Tronix286/i8080_clock/pics/photo_2023-03-10_09-42-11.jpg

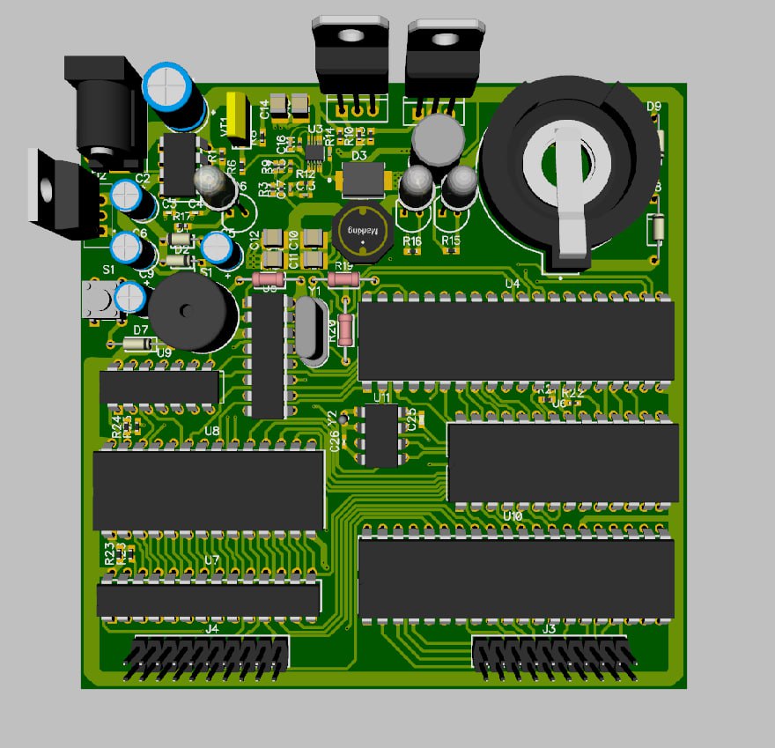
pics/photo_2023-03-10_09-42-11.jpg
