Tronix286/i8080_clock/pics/photo_2023-10-03_08-44-36.jpg

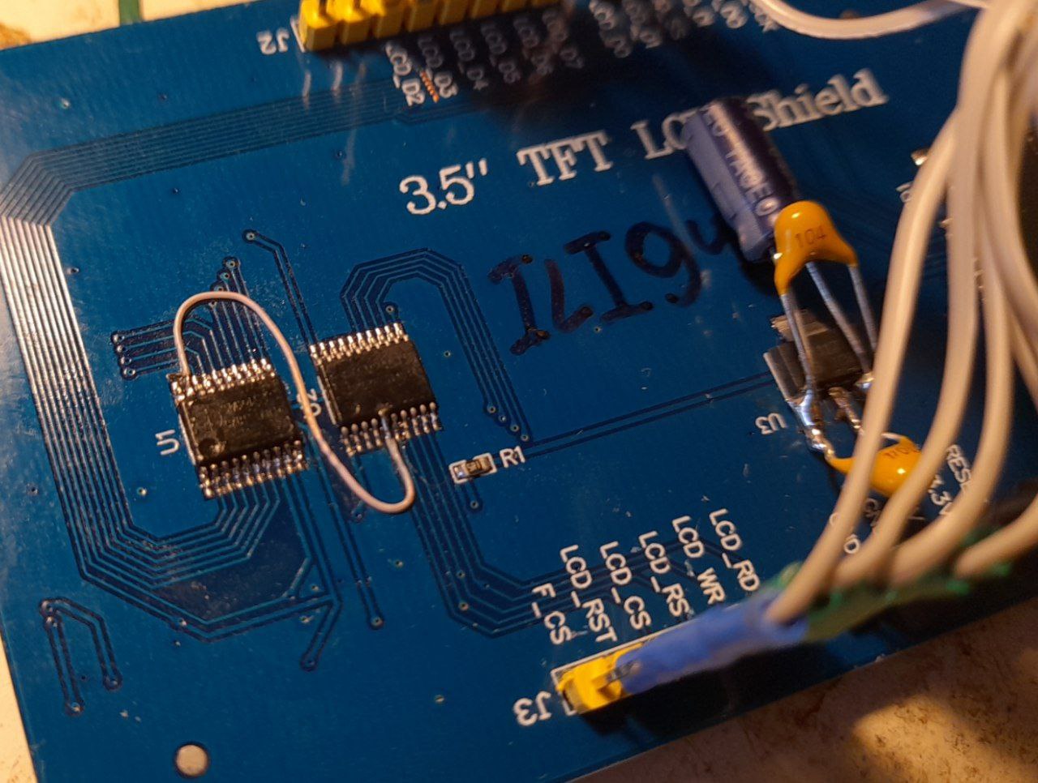
pics/photo_2023-10-03_08-44-36.jpg
