Tronix286/i8080_clock/hardware/DipTrace Schematic - clock_v1_1.pdf

## GND

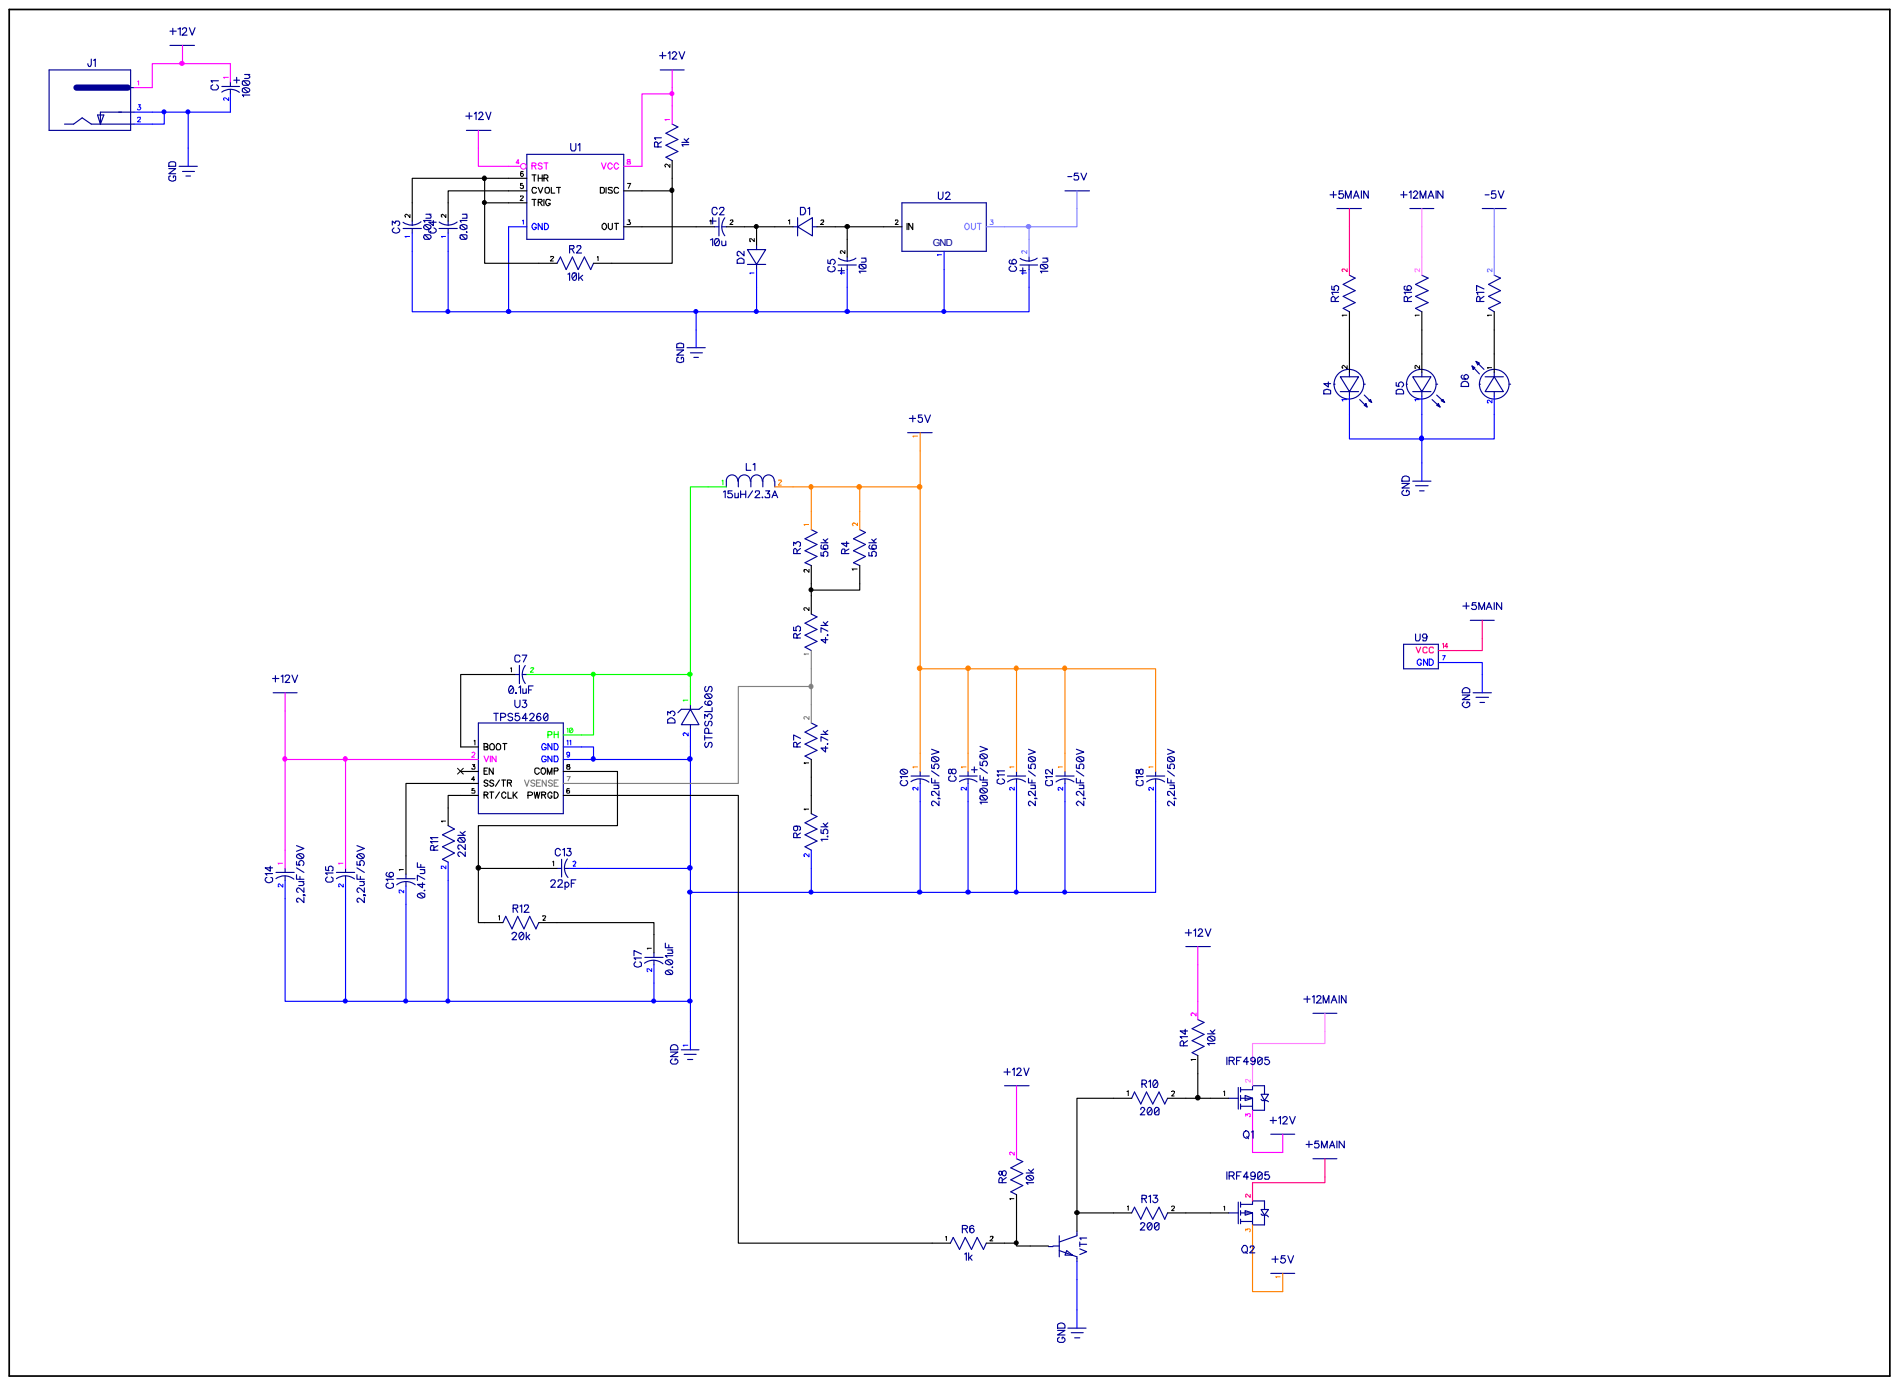
[picture p8: page 1]

## D_BUS

## ADDR

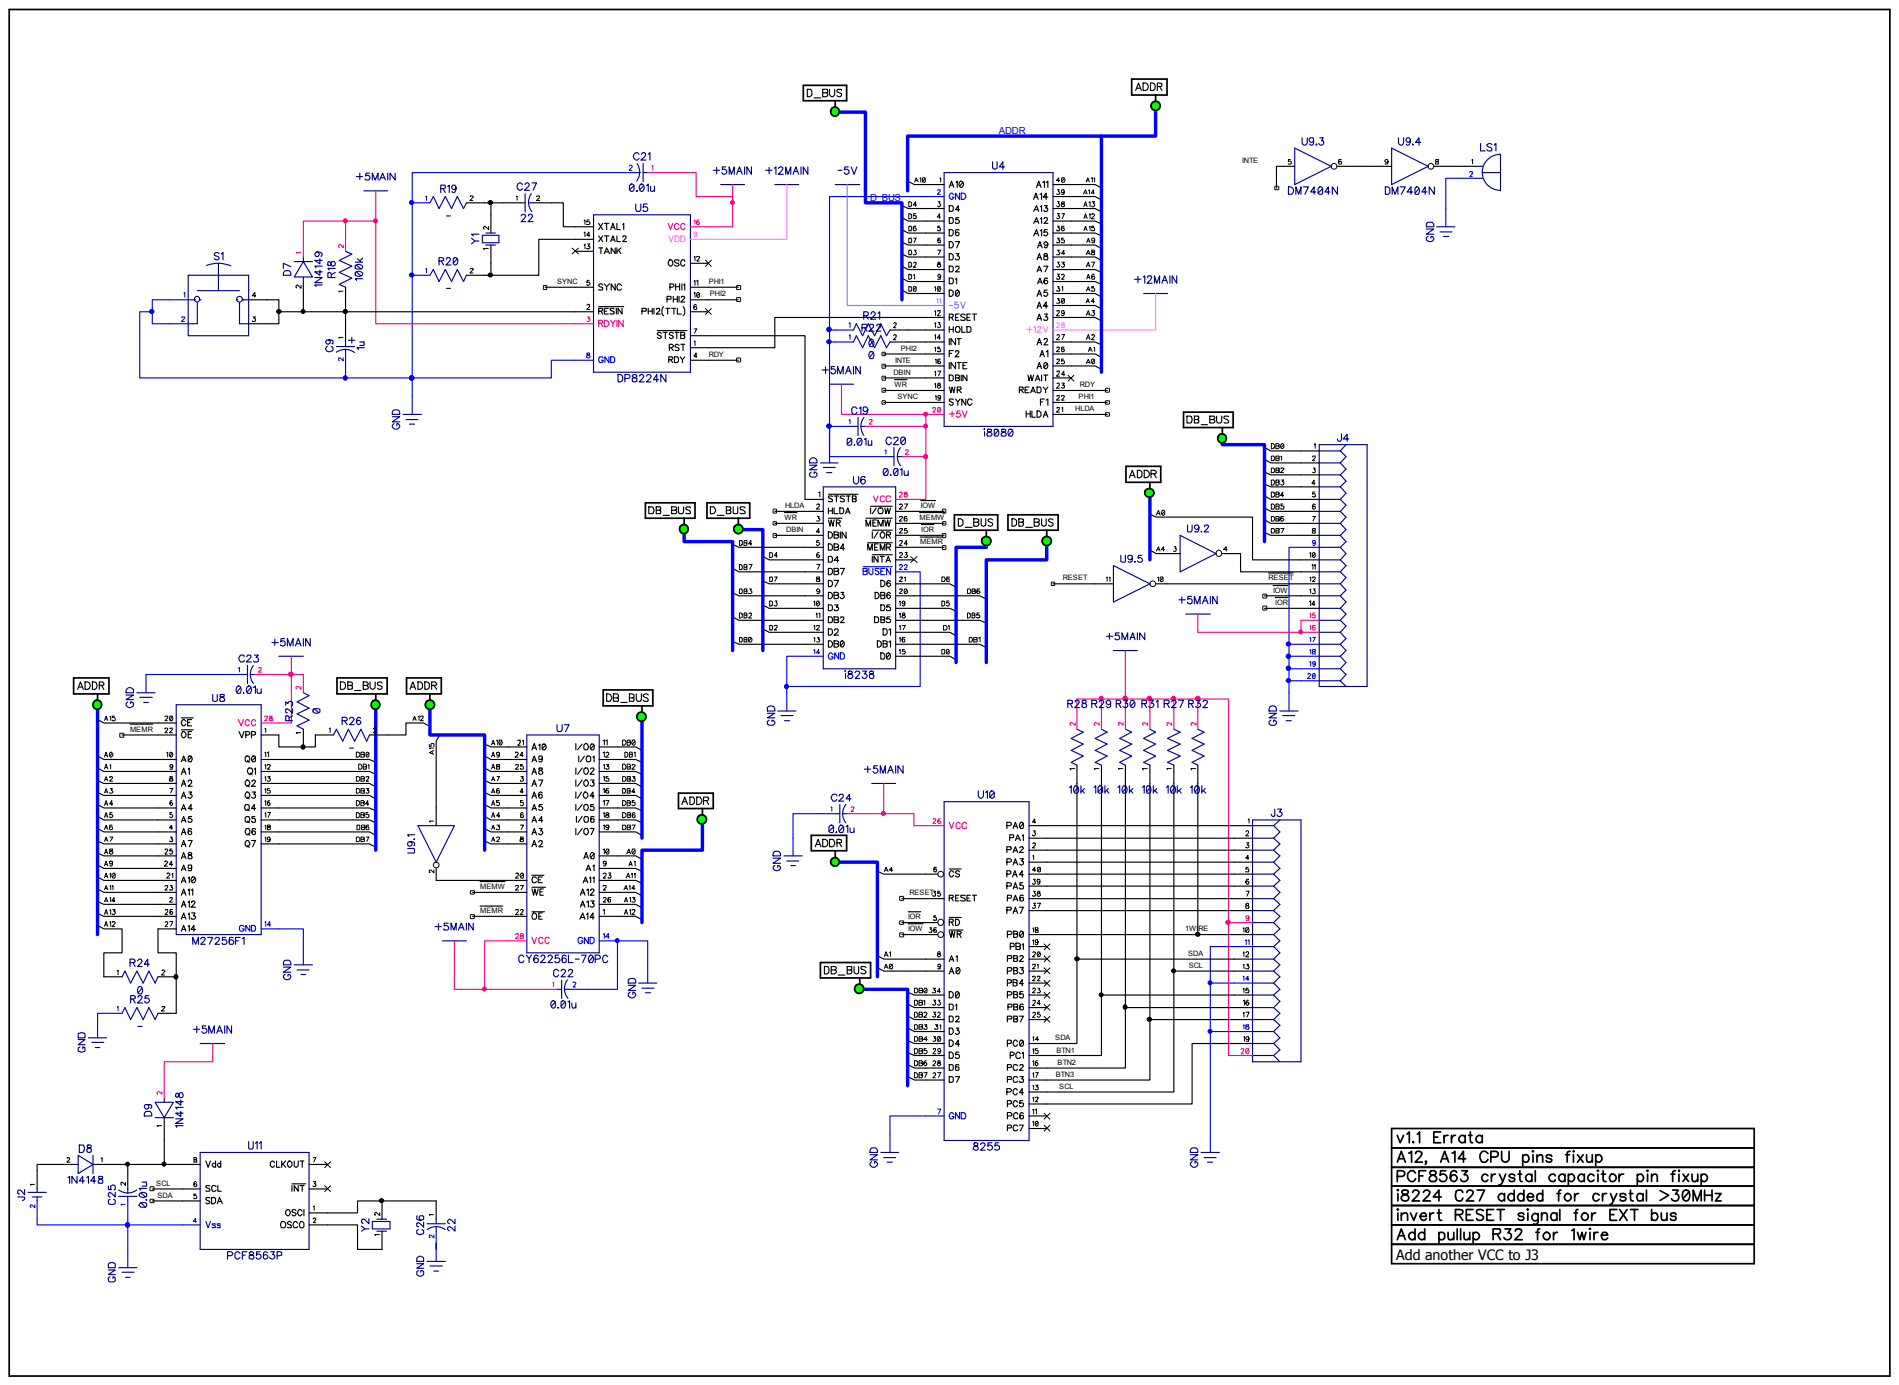
[picture p9: page 2]
SYNC; PHI1; PHI2; RDY; HLDA; DBIN; MEMW; IOW; IOR; MEMR; RESET; SCL; SDA; BTN1; BTN2; BTN3; 1WIRE; INTE

Add another VCC to J3
