Tronix286/i8080_clock/(list of files, drawings)

Other design files:
hardware/clock_v0_0.dip
hardware/clock_v1_0.dch
hardware/clock_v1_1.dch
hardware/clock_v1_1.dip
