Tronix286/i8080_clock/software/firmware/pic.h

//////////////////////////////////////////////////////////////////////////////////	 
//本程序只供学习使用，未经作者许可，不得用于其它任何用途
//测试硬件：单片机STC12C5A60S2,晶振30M  单片机工作电压3.3V
//QDtech-LCD液晶驱动 for C51
//xiao冯@ShenZhen QDtech co.,LTD
//公司网站:www.qdtft.com
//淘宝网站：http://qdtech.taobao.com
//wiki技术网站：http://www.lcdwiki.com
//我司提供技术支持，任何技术问题欢迎随时交流学习
//固话(传真) :+86 0755-23594567 
//手机:15989313508（冯工） 
//邮箱:lcdwiki01@gmail.com    support@lcdwiki.com    goodtft@163.com
//技术支持QQ:3002773612  3002778157
//技术交流QQ群:324828016
//创建日期:2018/7/7
//版本：V1.0
//版权所有，盗版必究。
//Copyright(C) 深圳市全动电子技术有限公司 2018-2028
//All rights reserved
//********************************************************************************
//=========================================电源接线================================================//
//5V接DC 5V电源
//GND接地
//=======================================液晶屏数据线接线==========================================//
//本模块默认数据总线类型为16位并口
//液晶屏模块             C51单片机
// DB0~DB7       接       P00~P07        //数据低8位
// DB8~DB15      接       P20~P27        //数据高8位
//=======================================液晶屏控制线接线==========================================//
//液晶屏模块             C51单片机
// LCD_CS        接        P13           //片选控制信号
// LCD_RST       接        P33           //复位信号
// LCD_RS        接        P12           //数据/命令选择控制信号
// LCD_WR        接        P11           //写控制信号
// LCD_RD        接        P10           //读控制信号
//=========================================触摸屏接线=========================================//
//STC89C52RC单片机ROM太小，无法运行带触摸功能的程序，所以触摸屏不需要接线
//不使用触摸或者模块本身不带触摸，则可不连接
//触摸屏使用的数据总线类型为SPI
//触摸屏模块             C51单片机
//  T_CLK        接        P36          //触摸屏SPI时钟信号
//  T_CS         接        P37          //触摸屏片选控制信号
//  T_DIN        接        P34          //触摸屏SPI写信号
//  T_DO         接        P35          //触摸屏SPI读信号
//  T_IRQ        接        P40          //触摸屏响应检查信号，如单片机无P4组，请自行更改其他可用IO并修改代码定义
//**************************************************************************************************/	
#ifndef __PIC_H
#define __PIC_H 

unsigned char gImage_temperature[512] = { /* 0X10,0X04,0X00,0X20,0X00,0X20, */
0X00,0X00,0X00,0X00,0X06,0XDF,0XB2,0X00,0X00,0X00,0X00,0X00,0X00,0X00,0X00,0X00,
0X00,0X00,0X00,0X00,0X6F,0XA7,0XDE,0X10,0X00,0X00,0X00,0X00,0X00,0X00,0X00,0X00,
0X00,0X00,0X00,0X00,0XDA,0X00,0X0F,0X70,0X00,0X00,0X00,0X00,0X00,0X00,0X00,0X00,
0X00,0X00,0X00,0X00,0XF5,0X00,0X0A,0XA0,0X00,0X00,0X00,0X00,0X00,0X00,0X00,0X00,
0X00,0X00,0X00,0X00,0XF5,0X00,0X0A,0XA0,0X00,0X00,0X00,0X00,0X00,0X00,0X00,0X00,
0X03,0XAA,0XAA,0X30,0XF5,0X00,0X0A,0XA0,0X00,0X00,0X00,0X00,0X00,0X00,0X00,0X00,
0X03,0XAA,0XAA,0X30,0XF5,0X00,0X0A,0XA0,0X00,0X00,0X00,0X00,0X00,0X00,0X00,0X00,
0X00,0X00,0X00,0X00,0XF5,0X00,0X0A,0XA0,0X00,0X00,0X00,0X00,0X00,0X00,0X00,0X00,
0X00,0X00,0XBF,0X60,0XF5,0X00,0X0A,0XA0,0X00,0X00,0X00,0X00,0X00,0X00,0X00,0X00,
0X00,0X00,0X25,0X00,0XF5,0X00,0X0A,0XA0,0X00,0X06,0X9A,0X83,0X00,0X02,0X85,0X00,
0X00,0X00,0X25,0X00,0XF5,0X00,0X0A,0XA0,0X00,0XCF,0XBA,0XDF,0X60,0X0F,0XEF,0X50,
0X00,0X00,0XBF,0X60,0XF5,0X00,0X0A,0XA0,0X06,0XF3,0X00,0X08,0XF1,0X3F,0X5E,0X80,
0X00,0X00,0X00,0X00,0XF5,0X00,0X0A,0XA0,0X09,0XB0,0X00,0X01,0XF3,0X0C,0XFF,0X20,
0X03,0XAA,0XAA,0X30,0XF5,0X06,0X0A,0XA0,0X0A,0XA0,0X00,0X00,0X10,0X00,0X30,0X00,
0X03,0XAA,0XAA,0X30,0XF5,0X5F,0X0A,0XA0,0X0A,0XA0,0X00,0X00,0X00,0X00,0X00,0X00,
0X00,0X00,0X00,0X00,0XF5,0X5F,0X0A,0XA0,0X0A,0XA0,0X00,0X00,0X00,0X00,0X00,0X00,
0X00,0X00,0XBF,0X60,0XF5,0X5F,0X0A,0XA0,0X0A,0XA0,0X00,0X00,0X00,0X00,0X00,0X00,
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
0X00,0X00,0X00,0X00,0X00,0X00,0X00,0X00,0X00,0X00,0X00,0X00,0X00,0X00,0X00,0X00,
0X00,0X00,0X00,0X00,0X00,0X00,0X00,0X00,0X00,0X00,0X00,0X00,0X00,0X00,0X00,0X00,
0X00,0X00,0X00,0X00,0X00,0X00,0X00,0X00,0X00,0X00,0X00,0X00,0X00,0X00,0X00,0X00,
};

#endif
