Tronix286/i8080_clock/software/firmware/types.h

#ifndef _TYPES_H
#define _TYPES_H
#include <stdint.h>
 typedef int8_t s8;
 typedef uint8_t u8;
 typedef int16_t s16;
 typedef uint16_t u16;
 typedef int32_t s32;
 typedef uint32_t u32;
 typedef int64_t s64;
 typedef uint64_t u64;
 
 typedef int8_t int8;
 typedef uint8_t uint8;
 typedef int16_t int16;
 typedef uint16_t uint16;
 typedef int32_t int32;
 typedef uint32_t uint32;
 typedef int64_t int64;
 typedef uint64_t uint64;
#endif /* _TYPES_H */
