Tronix286/i8080_clock/software/firmware/gui.c

//////////////////////////////////////////////////////////////////////////////////	 
//本程序只供学习使用，未经作者许可，不得用于其它任何用途
//测试硬件：单片机STC12C5A60S2,晶振30M  单片机工作电压3.3V
//QDtech-LCD液晶驱动 for C51
//xiao冯@ShenZhen QDtech co.,LTD
//公司网站:www.qdtft.com
//淘宝网站：http://qdtech.taobao.com
//wiki技术网站：http://www.lcdwiki.com
//我司提供技术支持，任何技术问题欢迎随时交流学习
//固话(传真) :+86 0755-23594567 
//手机:15989313508（冯工） 
//邮箱:lcdwiki01@gmail.com    support@lcdwiki.com    goodtft@163.com
//技术支持QQ:3002773612  3002778157
//技术交流QQ群:324828016
//创建日期:2018/7/7
//版本：V1.0
//版权所有，盗版必究。
//Copyright(C) 深圳市全动电子技术有限公司 2018-2028
//All rights reserved
//********************************************************************************
//=========================================电源接线================================================//
//5V接DC 5V电源
//GND接地
//=======================================液晶屏数据线接线==========================================//
//本模块默认数据总线类型为16位并口
//液晶屏模块             C51单片机
// DB0~DB7       接       P00~P07        //数据低8位
// DB8~DB15      接       P20~P27        //数据高8位
//=======================================液晶屏控制线接线==========================================//
//液晶屏模块             C51单片机
// LCD_CS        接        P13           //片选控制信号
// LCD_RST       接        P33           //复位信号
// LCD_RS        接        P12           //数据/命令选择控制信号
// LCD_WR        接        P11           //写控制信号
// LCD_RD        接        P10           //读控制信号
//=========================================触摸屏接线=========================================//
//STC89C52RC单片机ROM太小，无法运行带触摸功能的程序，所以触摸屏不需要接线
//不使用触摸或者模块本身不带触摸，则可不连接
//触摸屏使用的数据总线类型为SPI
//触摸屏模块             C51单片机
//  T_CLK        接        P36          //触摸屏SPI时钟信号
//  T_CS         接        P37          //触摸屏片选控制信号
//  T_DIN        接        P34          //触摸屏SPI写信号
//  T_DO         接        P35          //触摸屏SPI读信号
//  T_IRQ        接        P40          //触摸屏响应检查信号，如单片机无P4组，请自行更改其他可用IO并修改代码定义
//**************************************************************************************************/
	
#include <stdlib.h>
#include "lcd.h"
//#include "font.h" 
#include "gui.h"
#include "string.h"

/*******************************************************************
 * @name       :void GUI_DrawPoint(u16 x,u16 y,u16 color)
 * @date       :2018-08-09 
 * @function   :draw a point in LCD screen
 * @parameters :x:the x coordinate of the point
                y:the y coordinate of the point
								color:the color value of the point
 * @retvalue   :None
********************************************************************/

void GUI_DrawPoint(u16 x,u16 y,u16 color)
{
	LCD_SetCursor(x,y);//设置光标位置 
	LCD_WR_DATA_16Bit(color); 
}

void fill_ext(u16 height, u16 width, u16 color) __z88dk_fastcall
{
	#asm
	push b
	push d

	ld hl,8	; height (BC)
	add hl,sp
	ld c,(hl)
	inc hl
	ld b,(hl)
	;out 20h

	ld hl,10	; width (DE)
	add hl,sp
	ld e,(hl)
	inc hl
	ld d,(hl)
	;out 20h

	ld hl,4		; color (HL)
	add hl,sp
	ld a,(hl)
	inc hl
	ld l,(hl)
	mov h,a
	;out 20h

	push d		; save DE

do_ex_fill:
	mov a,l
	out LCD_DATA_PORT
	mov a,h
	out LCD_DATA_PORT
	dcx d

	mov     a,d         ;Copy D to A    (so as to compare DE with zero)
        ora     e           ;A = A | E      (are both D and E zero?)
        jnz     do_ex_fill  ;Jump to 'do_ex_fill:' if the zero-flag is not set. 

;	xra a
;	cmp d
;	jnz do_ex_fill
;	cmp e
;	jnz do_ex_fill

	pop d		; restore DE
	push d		; and save it again

	dcx b
	mov     a,b         ;Copy B to A    (so as to compare BC with zero)
        ora     c           ;A = A | C      (are both B and C zero?)
        jnz     do_ex_fill  ;Jump to 'do_ex_fill:' if the zero-flag is not set. 

;	xra a
;	cmp b
;	jnz do_ex_fill
;	cmp c
;	jnz do_ex_fill

	pop d		; restore DE to align stack

	pop d
	pop b
	#endasm
}

/*******************************************************************
 * @name       :void LCD_Fill(u16 sx,u16 sy,u16 ex,u16 ey,u16 color)
 * @date       :2018-08-09 
 * @function   :fill the specified area
 * @parameters :sx:the bebinning x coordinate of the specified area
                sy:the bebinning y coordinate of the specified area
								ex:the ending x coordinate of the specified area
								ey:the ending y coordinate of the specified area
								color:the filled color value
 * @retvalue   :None
********************************************************************/
void LCD_Fill(u16 sx,u16 sy,u16 ex,u16 ey,u16 color)
{  	
	u16 i,j;			
	u16 width=ex-sx+1; 		//得到填充的宽度
	u16 height=ey-sy+1;		//高度
	LCD_SetWindows(sx,sy,ex,ey);//设置显示窗口
/*	for(i=0;i<height;i++)
	{
		for(j=0;j<width;j++)
		LCD_WR_DATA_16Bit(color);	//写入数据 	 
	}
*/
	fill_ext(height,width,color);
	LCD_SetWindows(0,0,lcddev.width-1,lcddev.height-1);//恢复窗口设置为全屏
}

#if 0
/*******************************************************************
 * @name       :void LCD_DrawLine(u16 x1, u16 y1, u16 x2, u16 y2)
 * @date       :2018-08-09 
 * @function   :Draw a line between two points
 * @parameters :x1:the bebinning x coordinate of the line
                y1:the bebinning y coordinate of the line
								x2:the ending x coordinate of the line
								y2:the ending y coordinate of the line
 * @retvalue   :None
********************************************************************/
void LCD_DrawLine(u16 x1, u16 y1, u16 x2, u16 y2)
{
	u16 t; 
	int xerr=0,yerr=0,delta_x,delta_y,distance; 
	int incx,incy,uRow,uCol; 

	delta_x=x2-x1; //计算坐标增量 
	delta_y=y2-y1; 
	uRow=x1; 
	uCol=y1; 
	if(delta_x>0)incx=1; //设置单步方向 
	else if(delta_x==0)incx=0;//垂直线 
	else {incx=-1;delta_x=-delta_x;} 
	if(delta_y>0)incy=1; 
	else if(delta_y==0)incy=0;//水平线 
	else{incy=-1;delta_y=-delta_y;} 
	if( delta_x>delta_y)distance=delta_x; //选取基本增量坐标轴 
	else distance=delta_y; 
	for(t=0;t<=distance+1;t++ )//画线输出 
	{  
		LCD_DrawPoint(uRow,uCol);//画点 
		xerr+=delta_x ; 
		yerr+=delta_y ; 
		if(xerr>distance) 
		{ 
			xerr-=distance; 
			uRow+=incx; 
		} 
		if(yerr>distance) 
		{ 
			yerr-=distance; 
			uCol+=incy; 
		} 
	}  
} 

/*****************************************************************************
 * @name       :void LCD_DrawRectangle(u16 x1, u16 y1, u16 x2, u16 y2)
 * @date       :2018-08-09 
 * @function   :Draw a rectangle
 * @parameters :x1:the bebinning x coordinate of the rectangle
                y1:the bebinning y coordinate of the rectangle
								x2:the ending x coordinate of the rectangle
								y2:the ending y coordinate of the rectangle
 * @retvalue   :None
******************************************************************************/
void LCD_DrawRectangle(u16 x1, u16 y1, u16 x2, u16 y2)
{
	LCD_DrawLine(x1,y1,x2,y1);
	LCD_DrawLine(x1,y1,x1,y2);
	LCD_DrawLine(x1,y2,x2,y2);
	LCD_DrawLine(x2,y1,x2,y2);
}  

#endif
/*****************************************************************************
 * @name       :void LCD_DrawFillRectangle(u16 x1, u16 y1, u16 x2, u16 y2)
 * @date       :2018-08-09 
 * @function   :Filled a rectangle
 * @parameters :x1:the bebinning x coordinate of the filled rectangle
                y1:the bebinning y coordinate of the filled rectangle
								x2:the ending x coordinate of the filled rectangle
								y2:the ending y coordinate of the filled rectangle
 * @retvalue   :None
******************************************************************************/  
void LCD_DrawFillRectangle(u16 x1, u16 y1, u16 x2, u16 y2)
{
	LCD_Fill(x1,y1,x2,y2,POINT_COLOR);

}

#if 0 
/*****************************************************************************
 * @name       :void _draw_circle_8(int xc, int yc, int x, int y, u16 c)
 * @date       :2018-08-09 
 * @function   :8 symmetry circle drawing algorithm (internal call)
 * @parameters :xc:the x coordinate of the Circular center 
                yc:the y coordinate of the Circular center 
								x:the x coordinate relative to the Circular center 
								y:the y coordinate relative to the Circular center 
								c:the color value of the circle
 * @retvalue   :None
******************************************************************************/  
void _draw_circle_8(int xc, int yc, int x, int y, u16 c)
{
	GUI_DrawPoint(xc + x, yc + y, c);

	GUI_DrawPoint(xc - x, yc + y, c);

	GUI_DrawPoint(xc + x, yc - y, c);

	GUI_DrawPoint(xc - x, yc - y, c);

	GUI_DrawPoint(xc + y, yc + x, c);

	GUI_DrawPoint(xc - y, yc + x, c);

	GUI_DrawPoint(xc + y, yc - x, c);

	GUI_DrawPoint(xc - y, yc - x, c);
}

/*****************************************************************************
 * @name       :void gui_circle(int xc, int yc,u16 c,int r, int fill)
 * @date       :2018-08-09 
 * @function   :Draw a circle of specified size at a specified location
 * @parameters :xc:the x coordinate of the Circular center 
                yc:the y coordinate of the Circular center 
								r:Circular radius
								fill:1-filling,0-no filling
 * @retvalue   :None
******************************************************************************/  
void gui_circle(int xc, int yc,u16 c,int r, int fill)
{
	int x = 0, y = r, yi, d;

	d = 3 - 2 * r;


	if (fill) 
	{
		// 如果填充（画实心圆）
		while (x <= y) {
			for (yi = x; yi <= y; yi++)
				_draw_circle_8(xc, yc, x, yi, c);

			if (d < 0) {
				d = d + 4 * x + 6;
			} else {
				d = d + 4 * (x - y) + 10;
				y--;
			}
			x++;
		}
	} else 
	{
		// 如果不填充（画空心圆）
		while (x <= y) {
			_draw_circle_8(xc, yc, x, y, c);
			if (d < 0) {
				d = d + 4 * x + 6;
			} else {
				d = d + 4 * (x - y) + 10;
				y--;
			}
			x++;
		}
	}
}
#endif

#if 1
#include "font.h"
/*****************************************************************************
 * @name       :void LCD_ShowChar(u16 x,u16 y,u16 fc, u16 bc, u8 num,u8 size,u8 mode)
 * @date       :2018-08-09 
 * @function   :Display a single English character
 * @parameters :x:the bebinning x coordinate of the Character display position
                y:the bebinning y coordinate of the Character display position
								fc:the color value of display character
								bc:the background color of display character
								num:the ascii code of display character(0~94)
								size:the size of display character
								mode:0-no overlying,1-overlying
 * @retvalue   :None
******************************************************************************/ 
void LCD_ShowChar(u16 x,u16 y,u16 fc, u16 bc, u8 num,u8 mode)
{  
    u8 temp;
    u8 pos,t;
	u16 colortemp=POINT_COLOR;      
		   
	num=num-' ';//得到偏移后的值
	LCD_SetWindows(x,y,x+16/2-1,y+16-1);//设置单个文字显示窗口
/*
	if(!mode) //非叠加方式
	{
		
		for(pos=0;pos<16;pos++)
		{
			temp=asc2_1608[num][pos];		 //调用1608字体
			for(t=0;t<16/2;t++)
		    {                 
		        if(temp&0x01)LCD_WR_DATA_16Bit(fc); 
				else LCD_WR_DATA_16Bit(bc); 
				temp>>=1; 
				
		    }
			
		}	
	}else//叠加方式
*/
	{
		for(pos=0;pos<16;pos++)
		{
			temp=asc2_1608[num][pos];		 //调用1608字体
			for(t=0;t<16/2;t++)
		    {   
				POINT_COLOR=fc;              
		        if(temp&0x01)LCD_DrawPoint(x+t,y+pos);//画一个点    
		        temp>>=1; 
		    }
		}
	}
	POINT_COLOR=colortemp;	
	LCD_SetWindows(0,0,lcddev.width-1,lcddev.height-1);//恢复窗口为全屏    	   	 	  
}

/*****************************************************************************
 * @name       :void LCD_ShowString(u16 x,u16 y,u8 size,u8 *p,u8 mode)
 * @date       :2018-08-09 
 * @function   :Display English string
 * @parameters :x:the bebinning x coordinate of the English string
                y:the bebinning y coordinate of the English string
								p:the start address of the English string
								size:the size of display character
								mode:0-no overlying,1-overlying
 * @retvalue   :None
******************************************************************************/   	  
void LCD_ShowString(u16 x,u16 y,char *p,u8 mode)
{         
    while((*p<='~')&&(*p>=' '))//判断是不是非法字符!
    {   
		if(x>(lcddev.width-1)||y>(lcddev.height-1)) 
		return;     
        LCD_ShowChar(x,y,POINT_COLOR,BACK_COLOR,*p,mode);
        x+=16/2;
        p++;
    }  
} 
#endif

#if 0
/*****************************************************************************
 * @name       :u32 mypow(u8 m,u8 n)
 * @date       :2018-08-09 
 * @function   :get the nth power of m (internal call)
 * @parameters :m:the multiplier
                n:the power
 * @retvalue   :the nth power of m
******************************************************************************/ 
u32 mypow(u8 m,u8 n)
{
	u32 result=1;	 
	while(n--)result*=m;    
	return result;
}

/*****************************************************************************
 * @name       :void LCD_ShowNum(u16 x,u16 y,u32 num,u8 len,u8 size)
 * @date       :2018-08-09 
 * @function   :Display number
 * @parameters :x:the bebinning x coordinate of the number
                y:the bebinning y coordinate of the number
								num:the number(0~4294967295)
								len:the length of the display number
								size:the size of display number
 * @retvalue   :None
******************************************************************************/  			 
void LCD_ShowNum(u16 x,u16 y,u32 num,u8 len,u8 size)
{         	
	u8 t,temp;
	u8 enshow=0;						   
	for(t=0;t<len;t++)
	{
		temp=(num/mypow(10,len-t-1))%10;
		if(enshow==0&&t<(len-1))
		{
			if(temp==0)
			{
				LCD_ShowChar(x+(size/2)*t,y,POINT_COLOR,BACK_COLOR,' ',size,0);
				continue;
			}else enshow=1; 
		 	 
		}
	 	LCD_ShowChar(x+(size/2)*t,y,POINT_COLOR,BACK_COLOR,temp+'0',size,0); 
	}
} 

 
/*****************************************************************************
 * @name       :void Gui_Drawbmp16(u16 x,u16 y,const unsigned char *p)
 * @date       :2018-08-09 
 * @function   :Display a 16-bit BMP image
 * @parameters :x:the bebinning x coordinate of the BMP image
                y:the bebinning y coordinate of the BMP image
								p:the start address of image array
 * @retvalue   :None
******************************************************************************/ 
void Gui_Drawbmp16(u16 x,u16 y,const unsigned char *p) //显示40*40 QQ图片
{
  	int i; 
	unsigned char picH,picL; 
	LCD_SetWindows(x,y,x+40-1,y+40-1);//窗口设置
    for(i=0;i<40*40;i++)
	{	
	 	picL=*(p+i*2);	//数据低位在前
		picH=*(p+i*2+1);				
		LCD_WR_DATA_16Bit(picH<<8|picL);  						
	}	
	LCD_SetWindows(0,0,lcddev.width-1,lcddev.height-1);//恢复显示窗口为全屏	

}

#endif
//     ****************   TFT_eSPI here!

void pushBlock(uint16_t color, uint16_t h) __z88dk_fastcall
{
#asm
//	out 20h
	
	push h
	ld hl,6	; color BC
	add hl,sp
	ld c,(hl)
	inc hl
	ld b,(hl)
	pop h

do_ex_block:
	mov a,b
	out LCD_DATA_PORT
	mov a,c
	out LCD_DATA_PORT
	dcx h

	mov     a,h         
        ora     l           
        jnz     do_ex_block 
#endasm
}

/***************************************************************************************
** Function name:           drawFastVLine
** Description:             draw a vertical line
***************************************************************************************/
void drawFastVLine(uint16_t x, uint16_t y, uint16_t h, uint16_t color)
{

/*
  // Clipping
  if ((x < _vpX) || (x >= _vpW) || (y >= _vpH)) return;

  if (y < _vpY) { h += y - _vpY; y = _vpY; }

  if ((y + h) > _vpH) h = _vpH - y;
*/

  if (h < 1) return;

  LCD_SetWindows(x, y, x, y + h - 1);

  pushBlock(color, h);

}


/***************************************************************************************
** Function name:           drawFastHLine
** Description:             draw a horizontal line
***************************************************************************************/
void drawFastHLine(uint16_t x, uint16_t y, uint16_t w, uint16_t color)
{

/*
  // Clipping
  if ((y < _vpY) || (x >= _vpW) || (y >= _vpH)) return;

  if (x < _vpX) { w += x - _vpX; x = _vpX; }

  if ((x + w) > _vpW) w = _vpW - x;
*/

  if (w < 1) return;

  LCD_SetWindows(x, y, x + w - 1, y);

  pushBlock(color, w);

}

/***************************************************************************************
** Function name:           fillCircleHelper
** Description:             Support function for fillRoundRect()
***************************************************************************************/
// Support drawing roundrects, changed to horizontal lines (faster in sprites)
void fillCircleHelper(uint16_t x0, uint16_t y0, uint16_t r, uint8_t cornername, uint16_t delta, uint16_t color)
{
  int16_t f     = 1 - r;
  int16_t ddF_x = 1;
  int16_t ddF_y = -r - r;
  int16_t y     = 0;

  delta++;

  while (y < r) {
    if (f >= 0) {
      if (cornername & 0x1) drawFastHLine(x0 - y, y0 + r, y + y + delta, color);
      if (cornername & 0x2) drawFastHLine(x0 - y, y0 - r, y + y + delta, color);
      r--;
      ddF_y += 2;
      f     += ddF_y;
    }

    y++;
    ddF_x += 2;
    f     += ddF_x;

    if (cornername & 0x1) drawFastHLine(x0 - r, y0 + y, r + r + delta, color);
    if (cornername & 0x2) drawFastHLine(x0 - r, y0 - y, r + r + delta, color);
  }
}

/***************************************************************************************
** Function name:           fillRoundRect
** Description:             Draw a rounded corner filled rectangle
***************************************************************************************/
// Fill a rounded rectangle, changed to horizontal lines (faster in sprites)
void fillRoundRect(uint16_t x, uint16_t y, uint16_t w, uint16_t h, uint16_t r, uint16_t color)
{

  // smarter version
  LCD_Fill(x, y + r, x+w, y+h - r, color);

  // draw four corners
  fillCircleHelper(x + r, y + h - r - 1, r, 1, w - r - r - 1, color);
  fillCircleHelper(x + r    , y + r, r, 2, w - r - r - 1, color);

}

#if 0
// Swap any type
//void transpose(uint16_t *a, uint16_t *b) { uint16_t t = a; a = b; b = t; }

#define transpose(x, y, T) do { T SWAP = x; x = y; y = SWAP; } while (0)

/***************************************************************************************
** Function name:           drawLine
** Description:             draw a line between 2 arbitrary points
***************************************************************************************/
// Bresenham's algorithm - thx wikipedia - speed enhanced by Bodmer to use
// an efficient FastH/V Line draw routine for line segments of 2 pixels or more
void drawLine(int16_t x0, int16_t y0, int16_t x1, int16_t y1, uint16_t color)
{
  uint8_t steep = abs(y1 - y0) > abs(x1 - x0);
  if (steep) {
    transpose(x0, y0, uint16_t);
    transpose(x1, y1, uint16_t);
  }

  if (x0 > x1) {
    transpose(x0, x1, uint16_t);
    transpose(y0, y1, uint16_t);
  }

  int16_t dx = x1 - x0, dy = abs(y1 - y0);;

  int16_t err = dx >> 1, ystep = -1, xs = x0, dlen = 0;

  if (y0 < y1) ystep = 1;

  // Split into steep and not steep for FastH/V separation
  if (steep) {
    for (; x0 <= x1; x0++) {
      dlen++;
      err -= dy;
      if (err < 0) {
        if (dlen == 1) GUI_DrawPoint(y0, xs, color);
        else drawFastVLine(y0, xs, dlen, color);
        dlen = 0;
        y0 += ystep; xs = x0 + 1;
        err += dx;
      }
    }
    if (dlen) drawFastVLine(y0, xs, dlen, color);
  }
  else
  {
    for (; x0 <= x1; x0++) {
      dlen++;
      err -= dy;
      if (err < 0) {
        if (dlen == 1) GUI_DrawPoint(xs, y0, color);
        else drawFastHLine(xs, y0, dlen, color);
        dlen = 0;
        y0 += ystep; xs = x0 + 1;
        err += dx;
      }
    }
    if (dlen) drawFastHLine(xs, y0, dlen, color);
  }
#endif

}
