Tronix286/i8080_clock/software/firmware/test.c

//////////////////////////////////////////////////////////////////////////////////	 
//本程序只供学习使用，未经作者许可，不得用于其它任何用途
//测试硬件：单片机STC12C5A60S2,晶振30M  单片机工作电压3.3V
//QDtech-LCD液晶驱动 for C51
//xiao冯@ShenZhen QDtech co.,LTD
//公司网站:www.qdtft.com
//淘宝网站：http://qdtech.taobao.com
//wiki技术网站：http://www.lcdwiki.com
//我司提供技术支持，任何技术问题欢迎随时交流学习
//固话(传真) :+86 0755-23594567 
//手机:15989313508（冯工） 
//邮箱:lcdwiki01@gmail.com    support@lcdwiki.com    goodtft@163.com
//技术支持QQ:3002773612  3002778157
//技术交流QQ群:324828016
//创建日期:2018/7/7
//版本：V1.0
//版权所有，盗版必究。
//Copyright(C) 深圳市全动电子技术有限公司 2018-2028
//All rights reserved
//********************************************************************************
//=========================================电源接线================================================//
//5V接DC 5V电源
//GND接地
//=======================================液晶屏数据线接线==========================================//
//本模块默认数据总线类型为16位并口
//液晶屏模块             C51单片机
// DB0~DB7       接       P00~P07        //数据低8位
// DB8~DB15      接       P20~P27        //数据高8位
//=======================================液晶屏控制线接线==========================================//
//液晶屏模块             C51单片机
// LCD_CS        接        P13           //片选控制信号
// LCD_RST       接        P33           //复位信号
// LCD_RS        接        P12           //数据/命令选择控制信号
// LCD_WR        接        P11           //写控制信号
// LCD_RD        接        P10           //读控制信号
//=========================================触摸屏接线=========================================//
//STC89C52RC单片机ROM太小，无法运行带触摸功能的程序，所以触摸屏不需要接线
//不使用触摸或者模块本身不带触摸，则可不连接
//触摸屏使用的数据总线类型为SPI
//触摸屏模块             C51单片机
//  T_CLK        接        P36          //触摸屏SPI时钟信号
//  T_CS         接        P37          //触摸屏片选控制信号
//  T_DIN        接        P34          //触摸屏SPI写信号
//  T_DO         接        P35          //触摸屏SPI读信号
//  T_IRQ        接        P40          //触摸屏响应检查信号，如单片机无P4组，请自行更改其他可用IO并修改代码定义
//**************************************************************************************************/	
#include <stdio.h>
#include <stdlib.h>
#include "lcd.h"
#include "string.h"
#include "gui.h"
#include "test.h"
#include "pic.h"


//========================variable==========================//
static const u16 ColorTab[5]={RED,GREEN,BLUE,YELLOW,BRED};//定义颜色数组
static const u16 ColornTab[8]={RED,MAGENTA,GREEN,DARKBLUE,BLUE,BLACK,LIGHTGREEN};
//=====================end of variable======================//

/*****************************************************************************
 * @name       :void DrawTestPage(u8 *str)
 * @date       :2018-08-09 
 * @function   :Drawing test interface
 * @parameters :str:the start address of the Chinese and English strings
 * @retvalue   :None
******************************************************************************/ 
void DrawTestPage(char *str)
{
//绘制固定栏up
//LCD_Clear(WHITE);
LCD_Clear(GREEN);
LCD_Fill(0,0,lcddev.width,20,BLUE);
//绘制固定栏down
LCD_Fill(0,lcddev.height-20,lcddev.width,lcddev.height,BLUE);
POINT_COLOR=WHITE;
Gui_StrCenter(0,2,WHITE,BLUE,str,16,1);//居中显示
Gui_StrCenter(0,lcddev.height-18,WHITE,BLUE,"http://www.lcdwiki.com",16,1);//居中显示
//绘制测试区域
//LCD_Fill(0,20,lcddev.width,lcddev.height-20,WHITE);
}

/*****************************************************************************
 * @name       :void main_test(void)
 * @date       :2018-08-09 
 * @function   :Drawing the main Interface of the Comprehensive Test Program
 * @parameters :None
 * @retvalue   :None
******************************************************************************/
void main_test(void)
{
	DrawTestPage("1241234234");
	
	Gui_StrCenter(0,30,RED,BLUE,"全动电子",16,1);//居中显示
	Gui_StrCenter(0,60,RED,BLUE,"综合测试程序",16,1);//居中显示	
	Gui_StrCenter(0,90,MAGENTA,BLUE,"3.5\" ILI9486 320X480",16,1);//居中显示
	Gui_StrCenter(0,120,BLUE,BLUE,"xiaoFeng@QDtech 2018-11-13",16,1);//居中显示
	msleep(1500);		
	msleep(1500);
}

/*****************************************************************************
 * @name       :void Test_Color(void)
 * @date       :2018-08-09 
 * @function   :Color fill test(white,black,red,green,blue)
 * @parameters :None
 * @retvalue   :None
******************************************************************************/
void Test_Color(void)
{
	//DrawTestPage("测试1:纯色填充测试");
	LCD_Fill(0,0,lcddev.width,lcddev.height,WHITE);
	Show_Str(20,30,BLUE,YELLOW,"BL Test",16,1);msleep(800);
	LCD_Fill(0,0,lcddev.width,lcddev.height,RED);
	Show_Str(20,30,BLUE,YELLOW,"RED ",16,1);msleep(800);
	LCD_Fill(0,0,lcddev.width,lcddev.height,GREEN);
	Show_Str(20,30,BLUE,YELLOW,"GREEN ",16,1);msleep(800);
	LCD_Fill(0,0,lcddev.width,lcddev.height,BLUE);
	Show_Str(20,30,RED,YELLOW,"BLUE ",16,1);msleep(800);
}

/*****************************************************************************
 * @name       :void Test_FillRec(void)
 * @date       :2018-08-09 
 * @function   :Rectangular display and fill test
								Display red,green,blue,yellow,pink rectangular boxes in turn,
								1500 milliseconds later,
								Fill the rectangle in red,green,blue,yellow and pink in turn
 * @parameters :None
 * @retvalue   :None
******************************************************************************/
void Test_FillRec(void)
{
	u8 i=0;
	DrawTestPage("测试3:GUI矩形填充测试");
	LCD_Fill(0,20,lcddev.width,lcddev.height-20,WHITE);
	for (i=0; i<5; i++) 
	{
		POINT_COLOR=ColorTab[i];
		LCD_DrawRectangle(lcddev.width/2-80+(i*15),lcddev.height/2-80+(i*15),lcddev.width/2-80+(i*15)+60,lcddev.height/2-80+(i*15)+60); 
	}
	msleep(1500);	
	LCD_Fill(0,20,lcddev.width-1,lcddev.height-20,WHITE); 
	for (i=0; i<5; i++) 
	{
		POINT_COLOR=ColorTab[i];
		LCD_DrawFillRectangle(lcddev.width/2-80+(i*15),lcddev.height/2-80+(i*15),lcddev.width/2-80+(i*15)+60,lcddev.height/2-80+(i*15)+60); 		
	}
	msleep(1500);
}

/*****************************************************************************
 * @name       :void Test_Circle(void)
 * @date       :2018-08-09 
 * @function   :circular display and fill test
								Display red,green,blue,yellow,pink circular boxes in turn,
								1500 milliseconds later,
								Fill the circular in red,green,blue,yellow and pink in turn
 * @parameters :None
 * @retvalue   :None
******************************************************************************/
void Test_Circle(void)
{
	u8 i=0;
	DrawTestPage("测试4:GUI画圆填充测试");
	LCD_Fill(0,20,lcddev.width,lcddev.height-20,WHITE);
	for (i=0; i<5; i++)  
		gui_circle(lcddev.width/2-80+(i*25),lcddev.height/2-50+(i*25),ColorTab[i],30,0);
	msleep(1500);	
	LCD_Fill(0,20,lcddev.width-1,lcddev.height-20,WHITE); 
	for (i=0; i<5; i++) 
	  	gui_circle(lcddev.width/2-80+(i*25),lcddev.height/2-50+(i*25),ColorTab[i],30,1);
	msleep(1500);
}

/*****************************************************************************
 * @name       :void Test_Triangle(void)
 * @date       :2018-08-09 
 * @function   :triangle display and fill test
								Display red,green,blue,yellow,pink triangle boxes in turn,
								1500 milliseconds later,
								Fill the triangle in red,green,blue,yellow and pink in turn
 * @parameters :None
 * @retvalue   :None
******************************************************************************/
void Test_Triangle(void)
{
	u8 i=0;
	DrawTestPage("测试5:GUI Triangle填充测试");
	LCD_Fill(0,20,lcddev.width,lcddev.height-20,WHITE);
	for(i=0;i<5;i++)
	{
		POINT_COLOR=ColorTab[i];
		Draw_Triangel(lcddev.width/2-80+(i*20),lcddev.height/2-20+(i*15),lcddev.width/2-50-1+(i*20),lcddev.height/2-20-52-1+(i*15),lcddev.width/2-20-1+(i*20),lcddev.height/2-20+(i*15));
	}
	msleep(1500);	
	LCD_Fill(0,20,lcddev.width-1,lcddev.height-20,WHITE); 
	for(i=0;i<5;i++)
	{
		POINT_COLOR=ColorTab[i];
		Fill_Triangel(lcddev.width/2-80+(i*20),lcddev.height/2-20+(i*15),lcddev.width/2-50-1+(i*20),lcddev.height/2-20-52-1+(i*15),lcddev.width/2-20-1+(i*20),lcddev.height/2-20+(i*15));
	}
	msleep(1500);
}

/*****************************************************************************
 * @name       :void English_Font_test(void)
 * @date       :2018-08-09 
 * @function   :English display test
 * @parameters :None
 * @retvalue   :None
******************************************************************************/
void English_Font_test(void)
{
	DrawTestPage("测试6:英文显示测试");
	POINT_COLOR=RED;
	BACK_COLOR=BLUE;
	LCD_ShowString(10,30,12,"6X12:abcdefghijklmnopqrstuvwxyz",0);
	LCD_ShowString(10,45,12,"6X12:ABCDEFGHIJKLMNOP0123456789",1);
	LCD_ShowString(10,60,12,"6X12:~!@#$%^&*()_+{}:<>?/|-+.",0);
	LCD_ShowString(10,80,16,"8X16:abcdefghijklmnopqrstuvw",0);
	LCD_ShowString(10,100,16,"8X16:ABCDEFGHIJKLMN01234567",1);
	LCD_ShowString(10,120,16,"8X16:~!@#$%^&*()_+{}:<>?/|",0); 
	msleep(1200);
}

/*****************************************************************************
 * @name       :void Chinese_Font_test(void)
 * @date       :2018-08-09 
 * @function   :chinese display test
 * @parameters :None
 * @retvalue   :None
******************************************************************************/
void Chinese_Font_test(void)
{	
	DrawTestPage("测试7:中文显示测试");
	Show_Str(10,30,BLUE,YELLOW,"16X16:全动电子技术有限公司欢迎您",16,0);
	Show_Str(10,50,BLUE,YELLOW,"16X16:Welcome全动电子",16,0);
	Show_Str(10,70,BLUE,YELLOW,"24X24:深圳市中文测试",24,1);
	Show_Str(10,100,BLUE,YELLOW,"32X32:字体测试",32,1);
	msleep(1200);
}

/*****************************************************************************
 * @name       :void Pic_test(void)
 * @date       :2018-08-09 
 * @function   :picture display test
 * @parameters :None
 * @retvalue   :None
******************************************************************************/
void Pic_test(void)
{
	DrawTestPage("测试8:图片显示测试");
	//LCD_Fill(0,20,lcddev.width,lcddev.height-20,WHITE);
	Gui_Drawbmp16(30,30,gImage_qq);
	Show_Str(30+12,75,BLUE,YELLOW,"QQ",16,1);
	Gui_Drawbmp16(90,30,gImage_qq);
	Show_Str(90+12,75,BLUE,YELLOW,"QQ",16,1);
	Gui_Drawbmp16(150,30,gImage_qq);
	Show_Str(150+12,75,BLUE,YELLOW,"QQ",16,1);
	msleep(1200);
}

/*****************************************************************************
 * @name       :void Rotate_Test(void)
 * @date       :2018-08-09 
 * @function   :rotate test
 * @parameters :None
 * @retvalue   :None
******************************************************************************/
void Rotate_Test(void)
{
	u8 i=0;
	char *Direction[4]={"Rotation:0","Rotation:90","Rotation:180","Rotation:270"};
	
	for(i=0;i<4;i++)
	{
	LCD_direction(i);
	DrawTestPage("测试9:屏幕角度测试");
	Show_Str(20,30,BLUE,YELLOW,Direction[i],16,1);
	Gui_Drawbmp16(30,50,gImage_qq);
	msleep(1000);msleep(1000);
	}
	LCD_direction(USE_HORIZONTAL);
}

/*****************************************************************************
 * @name       :void Touch_Test(void)
 * @date       :2018-08-09 
 * @function   :touch test
 * @parameters :None
 * @retvalue   :None
******************************************************************************/
void Touch_Test(void)
{ 
/*
	u8 i=0;
	u16 j=0;
	u16 colorTemp=0;		
	DrawTestPage("测试10:Touch测试  ");
	LCD_ShowString(lcddev.width-24,0,16,"RST",1);//显示清屏区域
	LCD_Fill(lcddev.width-52,2,lcddev.width-50+20,18,RED); 
	POINT_COLOR=RED;
	while(1)
	{	 	 
		if(Convert_Pos())			//触摸屏被按下
		{	
		 	if(tp_pixlcd.x<lcddev.width&&tp_pixlcd.y<lcddev.height)
			{	
				if(tp_pixlcd.x>(lcddev.width-24)&&tp_pixlcd.y<16)
				{
					DrawTestPage("测试10:Touch测试  ");//清除
					LCD_ShowString(lcddev.width-24,0,16,"RST",1);//显示清屏区域
					POINT_COLOR=colorTemp;
					LCD_Fill(lcddev.width-52,2,lcddev.width-50+20,18,POINT_COLOR); 
				}
				else if((tp_pixlcd.x>(lcddev.width-60)&&tp_pixlcd.x<(lcddev.width-50+20))&&tp_pixlcd.y<20)
				{
				LCD_Fill(lcddev.width-52,2,lcddev.width-50+20,18,ColorTab[j%5]); 
				POINT_COLOR=ColorTab[(j++)%5];
				colorTemp=POINT_COLOR;
				msleep(10);
				}

				else 
				TP_Draw_Big_Point(tp_pixlcd.x,tp_pixlcd.y,POINT_COLOR);    			   
			}
		}else msleep(10);	//没有按键按下的时候 	    				
	}   
*/
}

/*****************************************************************************
 * @name       :void Test_Read(void)
 * @date       :2018-11-13 
 * @function   :read test
 * @parameters :None
 * @retvalue   :None
******************************************************************************/
void Test_Read(void)
{
	u16 lcd_id,color;
	u8 buf[10] = {0},i;
	u8 cbuf[20] = {0};
	DrawTestPage("测试2:读ID和颜色值测试");
	LCD_Fill(0,20,lcddev.width,lcddev.height-20,WHITE);
	lcd_id = LCD_Read_ID();
	sprintf((char *)buf,"ID:0x%x",lcd_id);
	Show_Str(50,25,BLUE,YELLOW,buf,16,1);
	for (i=0; i<7; i++) 
	{
		POINT_COLOR=ColornTab[i];
		LCD_DrawFillRectangle(40-10,55+i*25-10,40+10,55+i*25+10);
		color = LCD_ReadPoint(40,55+i*25);
		sprintf((char *)cbuf,"read color:0x%04x",color);
		Show_Str(40+20,55+i*25-8,POINT_COLOR,YELLOW,cbuf,16,1);
	}
	msleep(1500);
}
