Tronix286/i8080_clock/(notices)

Notices in the files:
software/firmware/lcd.h:
Copyright(C) ÉîÛÚÊÐÈ«¶¯µç×Ó¼¼ÊõÓÐÏÞ¹«Ë¾ 2018-2028
All rights reserved
